johnsonm/flex-pcm-controller/README.txt

This is a low-current low-DC-voltage 2.5cm by 5cm PCM controller based
on a 555 timer.  It is built in KiCad.  The license, which applies to
all unique content (not inherited components) is in the LICENSE.txt
file.  Instructions for some potential modifications and use are in
the schematic.
