johnsonm/flex-pcm-controller/flex-pcm-controller.pdf

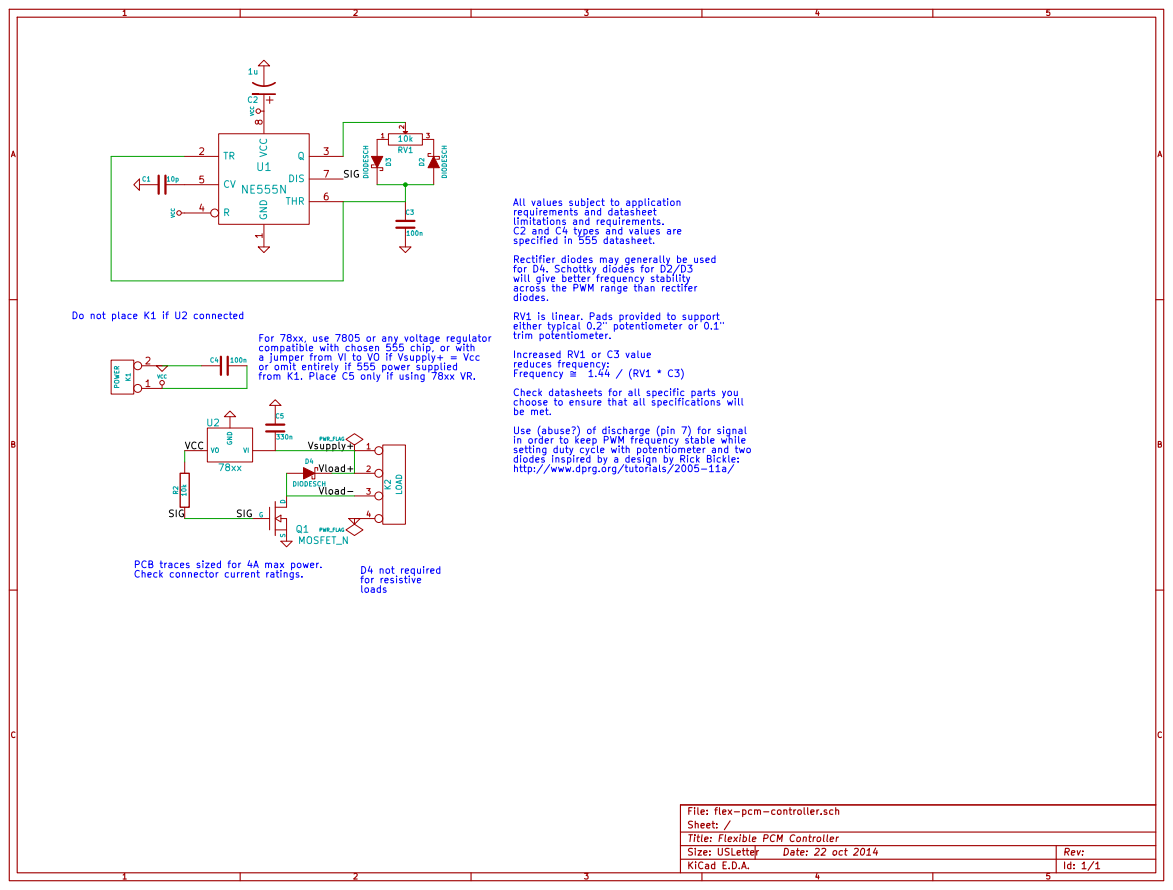
[picture p1: page 1]

requirements and datasheet
limitations and requirements.
C2 and C4 types and values are
specified in 555 datasheet.
Rectifier diodes may generally be used
for D4. Schottky diodes for D2/D3
will give better frequency stability
across the PWM range than rectifer diodes. RV1 is linear. Pads provided to support

Do not place K1 if U2 connected

either typical 0.2" potentiometer or 0.1"
trim potentiometer.
Increased RV1 or C3 value
reduces frequency:
Frequency 1.44 / (RV1 * C3)
Check datasheets for all specific parts you
choose to ensure that all specifications will be met. Use (abuse?) of discharge (pin 7) for signal

compatible with chosen 555 chip, or with
a jumper from VI to VO if Vsupply+ = Vcc
or omit entirely if 555 power supplied
from K1. Place C5 only if using 78xx VR. C5

in order to keep PWM frequency stable while
setting duty cycle with potentiometer and two

PCB traces sized for 4A max power.

File: flex-pcm-controller.sch
Sheet: /
Title: Flexible PCM Controller
