johnsonm/flex-pcm-controller/flex-pcm-controller.sch

## KiCad design flex-pcm-controller.sch (2014-10-23)

Schematic: flex-pcm-controller.sch

Parts:
C1: 10p; C1
C2: 1u
C3: 100n; C1
C4: 100n
C5: 330n
D2, D3, D4: DIODESCH; D3
K1: POWER
K2: LOAD
Q1: MOSFET_N; TO220_VERT
R2: 10k; R3
RV1: 10k; POTA_Fav
U1: NE555N
U2: 78xx

Notes on the sheet:
D4 not required for resistive loads
All values subject to application requirements and datasheet limitations and requirements. C2 and C4 types and values are specified in 555 datasheet. Rectifier diodes may generally be used for D4. Schottky diodes for D2/D3 will give better frequency stability across the PWM range than rectifer diod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
PCB traces sized for 4A max power. Check connector current ratings.
Do not place K1 if U2 connected
For 78xx, use 7805 or any voltage regulator compatible with chosen 555 chip, or with a jumper from VI to VO if Vsupply+ = Vcc or omit entirely if 555 power supplied from K1. Place C5 only if using 78xx VR.
