johnsonm/flex-pcm-controller/(commit log)

2014-09-16 Initial version of flexible 555-based PCM controller
    [flex-pcm-controller.kicad_pcb, flex-pcm-controller.sch]
2014-09-17 Remove PNP option, lay out to take half of a 5cm^2 board
    [flex-pcm-controller.brd, flex-pcm-controller.kicad_pcb, flex-pcm-controller.sch]
2014-09-17 Panelize 2up on 5x5cm board with perf
    [flex-pcm-controller-panel.brd]
2014-09-18 Electrolytic footprint, rearrange schematic
    Switch C2 footprint to be an electrolytic rather than film capacitor.
    Rearrange schematic to be more logical after removing PNP.
    Add PDF and SVG plots of schematic.
    [flex-pcm-controller-panel.brd, flex-pcm-controller.brd, flex-pcm-controller.sch]
2014-09-18 revert MOSFET descriptions to DGS/GDS footprint designations
    [flex-pcm-controller-panel.brd, flex-pcm-controller.brd]
2014-09-18 Add GND to LOAD connector for Vsupply+ == Vcc
    [flex-pcm-controller-panel.brd, flex-pcm-controller.brd, flex-pcm-controller.sch]
2014-09-19 Change internal cuts to mechanical holes; turn MOSFETs back-to-back
    Replaced the internal cuts with NPTH mechanical holes for the
    panelized snap line.
    Swapped the MOSFET locations and rotated one so that they are now
    back-to-back with the heat sink toward the middle to leave more
    options for the K2 LOAD connector. This should allow wires,
    headers, or 0.1" pitch screw connector terminal block connectors.
    [flex-pcm-controller-panel.brd, flex-pcm-controller.brd]
2014-09-24 remove silkscreen line on RV1 crossing screw hole
    [flex-pcm-controller-panel.brd, flex-pcm-controller.brd]
2014-09-28 move VCC trace away from mounting hole
    [flex-pcm-controller-panel.brd, flex-pcm-controller.brd]
2014-09-28 remove acute angle from SIG trace to GDS MOSFET
    [flex-pcm-controller-panel.brd, flex-pcm-controller.brd]
2014-10-04 add option for .1 pitch potentiometer
    [flex-pcm-controller-panel.brd, flex-pcm-controller.brd]
2014-10-05 move power components toward center to accomodate additional connector style; comment in schematic about potentiometer styles and connector current ratings; add gerber files
    [flex-pcm-controller-B_Cu.gbl, flex-pcm-controller-B_Mask.gbs, flex-pcm-controller-B_SilkS.gbo, flex-pcm-controller-Edge_Cuts.gbr, flex-pcm-controller-F_Cu.gtl, flex-pcm-controller-F_Mask.gts, flex-pcm-controller-F_SilkS.gto, flex-pcm-controller-NPTH.drl]
2014-10-05 re-route Vcc under 555 chip
    [flex-pcm-controller-B_Cu.gbl, flex-pcm-controller-B_Mask.gbs, flex-pcm-controller-B_SilkS.gbo, flex-pcm-controller-Edge_Cuts.gbr, flex-pcm-controller-F_Cu.gtl, flex-pcm-controller-F_Mask.gts, flex-pcm-controller-F_SilkS.gto, flex-pcm-controller-panel-B_Cu.gbl]
2014-10-06 replace R4 jumper with 780x voltage regulator; add its required C5 330nF capacitor
    [flex-pcm-controller-B_Cu.gbl, flex-pcm-controller-B_Mask.gbs, flex-pcm-controller-B_SilkS.gbo, flex-pcm-controller-Edge_Cuts.gbr, flex-pcm-controller-F_Cu.gtl, flex-pcm-controller-F_Mask.gts, flex-pcm-controller-F_SilkS.gto, flex-pcm-controller-panel-B_Cu.gbl]
2014-10-06 Replace mutually exclusive MOSFETs with single MOSFET
    Previously, there were two MOSFETs in the schematic, one for each pin
    configuration, to make it easy to place two components on the board.
    These have been replaced by a single MOSFET and an edited modules with
    two sets of pins, one for each of the GDS and DGS pinouts.
    [flex-pcm-controller-B_Cu.gbl, flex-pcm-controller-B_Mask.gbs, flex-pcm-controller-B_SilkS.gbo, flex-pcm-controller-Edge_Cuts.gbr, flex-pcm-controller-F_Cu.gtl, flex-pcm-controller-F_Mask.gts, flex-pcm-controller-F_SilkS.gto, flex-pcm-controller-panel-B_Cu.gbl]
2014-10-23 first changes from first proto boards
    - Larger holes for 0.2 pitch potentiometer
    - Larger holes for 4-connector
    - Renamed 7805 to 78xx with clarified instructions
    - Move MOSFET_N GDS designation away from 4-connector
    - Move +/- indication to be more visible around 4-connector
    [flex-pcm-controller-B_Cu.gbl, flex-pcm-controller-B_Mask.gbs, flex-pcm-controller-B_SilkS.gbo, flex-pcm-controller-Edge_Cuts.gbr, flex-pcm-controller-F_Cu.gtl, flex-pcm-controller-F_Mask.gts, flex-pcm-controller-F_SilkS.gto, flex-pcm-controller-panel-B_Cu.gbl]
2014-12-10 remove npth depanelization perf
    [flex-pcm-controller-B_Cu.gbl, flex-pcm-controller-B_Mask.gbs, flex-pcm-controller-B_SilkS.gbo, flex-pcm-controller-Edge_Cuts.gbr, flex-pcm-controller-F_Cu.gtl, flex-pcm-controller-F_Mask.gts, flex-pcm-controller-F_SilkS.gto, flex-pcm-controller-NPTH.drl]
2015-03-07 Update rendered schematics, add LICENSE and README
